Juventus-Technikerschule-HF/EduboardV2_ESP32-S3/EduboardV2_ESP32-S3/EduboardV2_ESP32-S3.kicad_pcb

## KiCad design EduboardV2_ESP32-S3/EduboardV2_ESP32-S3.kicad_pcb (2024-07-12)

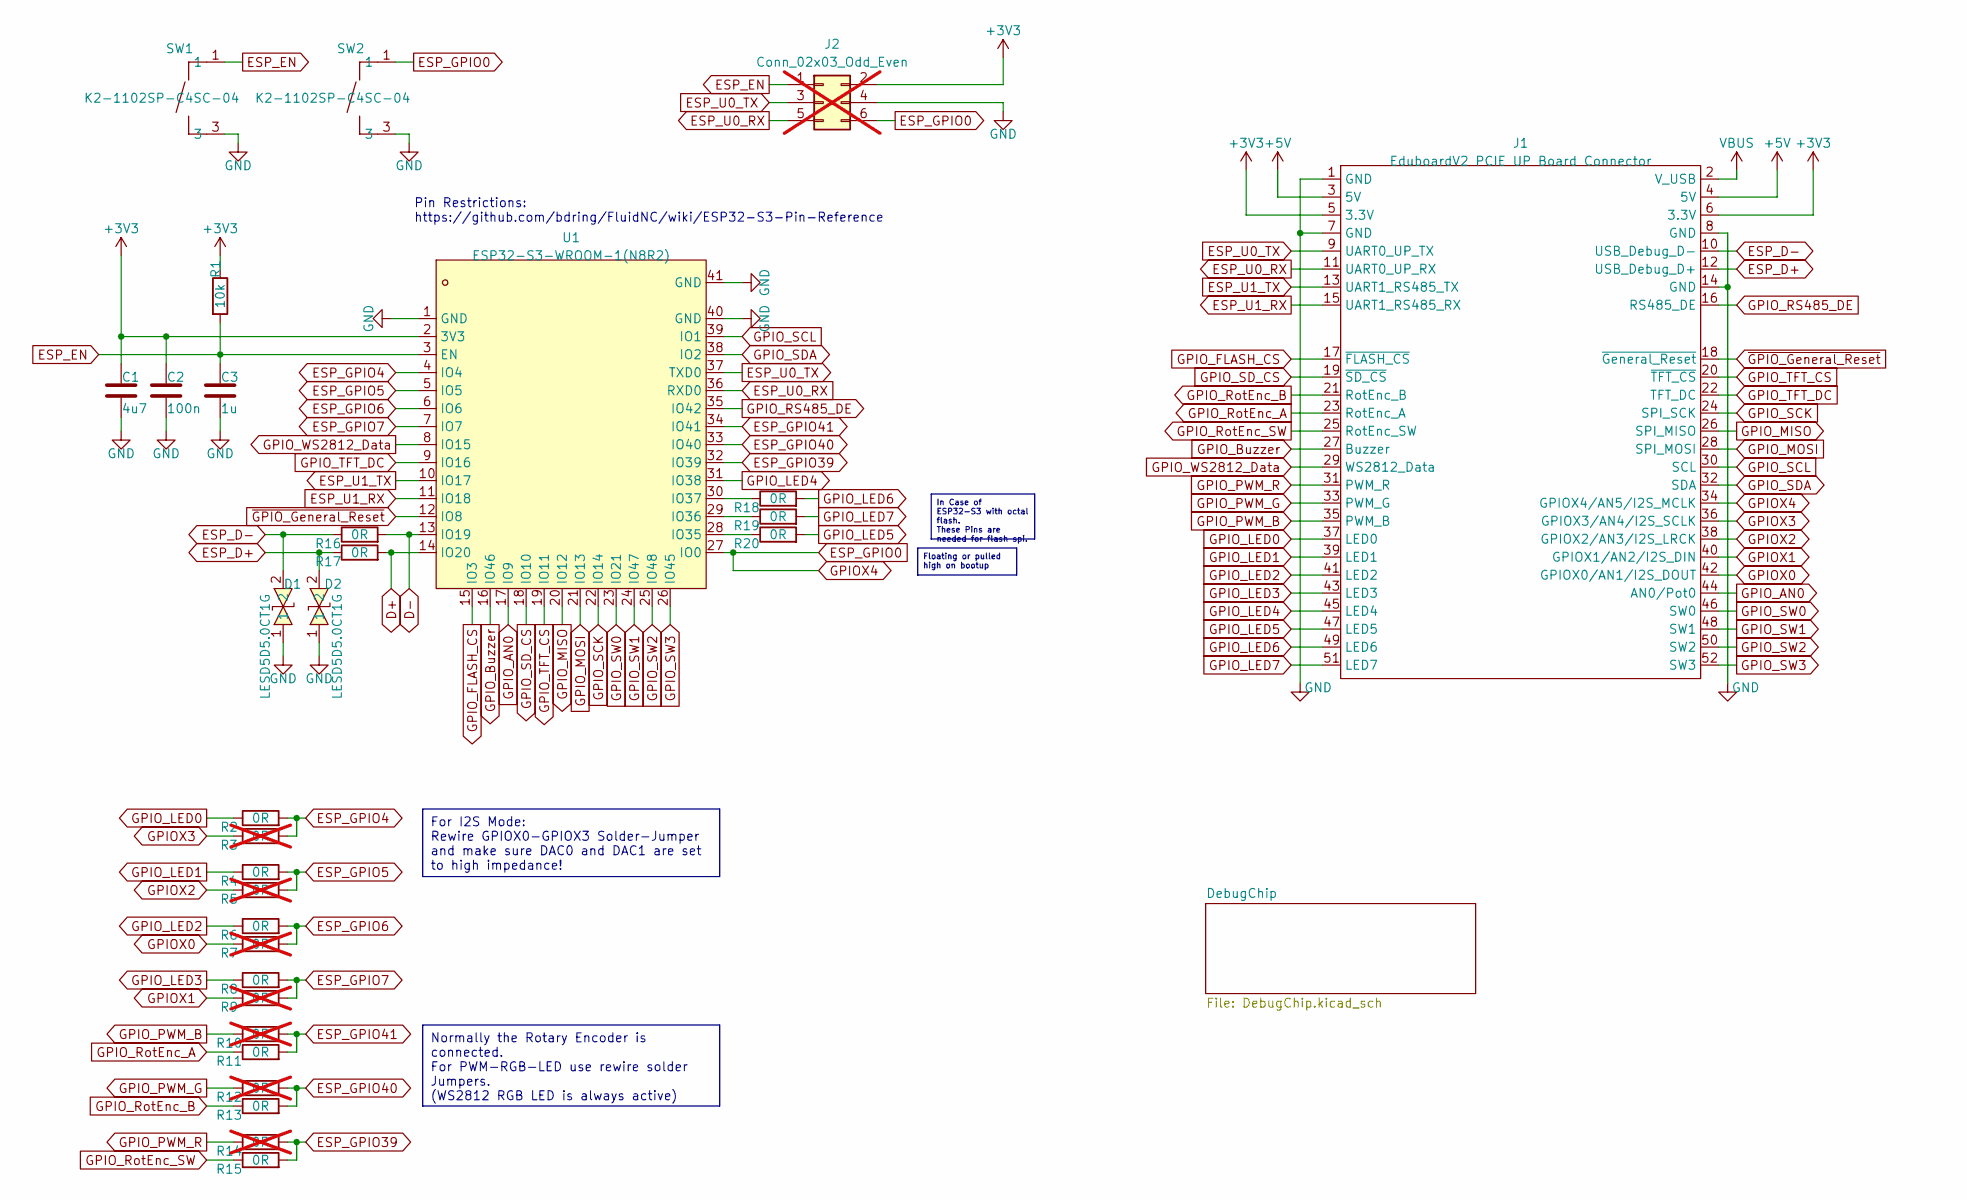
[picture p1: schematic EduboardV2_ESP32-S3.kicad_sch]

Parts:
C1: 4u7; C_0805_2012Metric; JLCPCB Part # C76642
C2: 100n; C_0603_1608Metric; JLCPCB Part # C105907
C3: 1u; C_0805_2012Metric; JLCPCB Part # C77083
D1, D2: LESD5D5.0CT1G; SOD-523_L1.2-W0.8-LS1.6-BI; LCSC Part C383211
J1: EduboardV2 PCIE UP Board Connector; mini-PCIe_F1_Full
J2: Conn_02x03_Odd_Even; PinHeader_2x03_P2.54mm_Vertical; not fitted
R1: 10k; R_0402_1005Metric; JLCPCB Part # C71617
R2, R4, R6, R8, R11, R13, R15, R16, R17, R18, R19, R20: 0R; R_0603_1608Metric; LCSC Part C465460
R3, R5, R7, R9, R10, R12, R14: 0R; R_0603_1608Metric; LCSC Part C465460; not fitted
SW1, SW2: K2-1102SP-C4SC-04; KEY-SMD_4P-L6.0-W6.0-P4.50-LS9.5-BL; LCSC Part C127509
U1: ESP32-S3-WROOM-1(N8R2); WIRELM-SMD_ESP32-S3-WROOM-1; LCSC Part C2913204

Connections:
+3V3: C1.2, C2.1, J1.5 (3.3V), J1.6 (3.3V), J2.2, R1.1, U1.2 (3V3)
+5V: J1.3 (5V), J1.4 (5V)
D+: R17.2, U1.14 (IO20)
D-: R16.2, U1.13 (IO19)
ESP_D+: D2.2, J1.12 (USB_Debug_D+), R17.1
ESP_D-: D1.2, J1.10 (USB_Debug_D-), R16.1
ESP_EN: C3.2, J2.1, R1.2, SW1.1, SW1.2, U1.3 (EN)
ESP_GPIO0: J1.34 (GPIOX4/AN5/I2S_MCLK), J2.6, SW2.1, SW2.2, U1.27 (IO0)
ESP_GPIO4: R2.2, R3.2, U1.4 (IO4)
ESP_GPIO5: R4.2, R5.2, U1.5 (IO5)
ESP_GPIO6: R6.2, R7.2, U1.6 (IO6)
ESP_GPIO7: R8.2, R9.2, U1.7 (IO7)
ESP_GPIO39: R14.2, R15.2, U1.32 (IO39)
ESP_GPIO40: R12.2, R13.2, U1.33 (IO40)
ESP_GPIO41: R10.2, R11.2, U1.34 (IO41)
ESP_U0_RX: J1.11 (UART0_UP_RX), J2.5, U1.36 (RXD0)
ESP_U0_TX: J1.9 (UART0_UP_TX), J2.3, U1.37 (TXD0)
ESP_U1_RX: J1.15 (UART1_RS485_RX), U1.11 (IO18)
ESP_U1_TX: J1.13 (UART1_RS485_TX), U1.10 (IO17)
GND: C1.1, C2.2, C3.1, D1.1, D2.1, J1.1 (GND), J1.7 (GND), J1.8 (GND), J1.14 (GND), J2.4, SW1.3, SW1.4, SW2.3, SW2.4, U1.1 (GND), U1.40 (GND), U1.41 (GND)
GPIOX0: J1.42 (GPIOX0/AN1/I2S_DOUT), R7.1
GPIOX1: J1.40 (GPIOX1/AN2/I2S_DIN), R9.1
GPIOX2: J1.38 (GPIOX2/AN3/I2S_LRCK), R5.1
GPIOX3: J1.36 (GPIOX3/AN4/I2S_SCLK), R3.1
GPIO_AN0: J1.44 (AN0/Pot0), U1.17 (IO9)
GPIO_Buzzer: J1.27 (Buzzer), U1.16 (IO46)
GPIO_FLASH_CS: J1.17 (~FLASH_CS), U1.15 (IO3)
GPIO_LED0: J1.37 (LED0), R2.1
GPIO_LED1: J1.39 (LED1), R4.1
GPIO_LED2: J1.41 (LED2), R6.1
GPIO_LED3: J1.43 (LED3), R8.1
GPIO_LED4: J1.45 (LED4), U1.31 (IO38)
GPIO_LED5: J1.47 (LED5), R20.2
GPIO_LED6: J1.49 (LED6), R18.2
GPIO_LED7: J1.51 (LED7), R19.2
GPIO_MISO: J1.26 (SPI_MISO), U1.20 (IO12)
GPIO_MOSI: J1.28 (SPI_MOSI), U1.21 (IO13)
GPIO_PWM_B: J1.35 (PWM_B), R10.1
GPIO_PWM_G: J1.33 (PWM_G), R12.1
GPIO_PWM_R: J1.31 (PWM_R), R14.1
GPIO_RS485_DE: J1.16 (RS485_DE), U1.35 (IO42)
GPIO_RotEnc_A: J1.23 (RotEnc_A), R11.1
GPIO_RotEnc_B: J1.21 (RotEnc_B), R13.1
GPIO_RotEnc_SW: J1.25 (RotEnc_SW), R15.1
GPIO_SCK: J1.24 (SPI_SCK), U1.22 (IO14)
GPIO_SCL: J1.30 (SCL), U1.39 (IO1)
GPIO_SDA: J1.32 (SDA), U1.38 (IO2)
GPIO_SD_CS: J1.19 (~SD_CS), U1.18 (IO10)
GPIO_SW0: J1.46 (SW0), U1.23 (IO21)
GPIO_SW1: J1.48 (SW1), U1.24 (IO47)
GPIO_SW2: J1.50 (SW2), U1.25 (IO48)
GPIO_SW3: J1.52 (SW3), U1.26 (IO45)
GPIO_TFT_CS: J1.20 (~TFT_CS), U1.19 (IO11)
GPIO_TFT_DC: J1.22 (TFT_DC), U1.9 (IO16)
GPIO_WS2812_Data: J1.29 (WS2812_Data), U1.8 (IO15)
unnamed: R20.1, U1.28 (IO35)
unnamed: R19.1, U1.29 (IO36)
unnamed: R18.1, U1.30 (IO37)
VBUS: J1.2 (V_USB)
~GPIO_General_Reset: J1.18 (~General_Reset), U1.12 (IO8)

Notes on the sheet:
For I2S Mode: Rewire GPIOX0-GPIOX3 Solder-Jumper and make sure DAC0 and DAC1 are set to high impedance!
Normally the Rotary Encoder is connected. For PWM-RGB-LED use rewire solder Jumpers. (WS2812 RGB LED is always active)
Floating or pulled high on bootup
In Case of ESP32-S3 with octal flash. These Pins are needed for flash spi.
Pin Restrictions: https://github.com/bdring/FluidNC/wiki/ESP32-S3-Pin-Reference

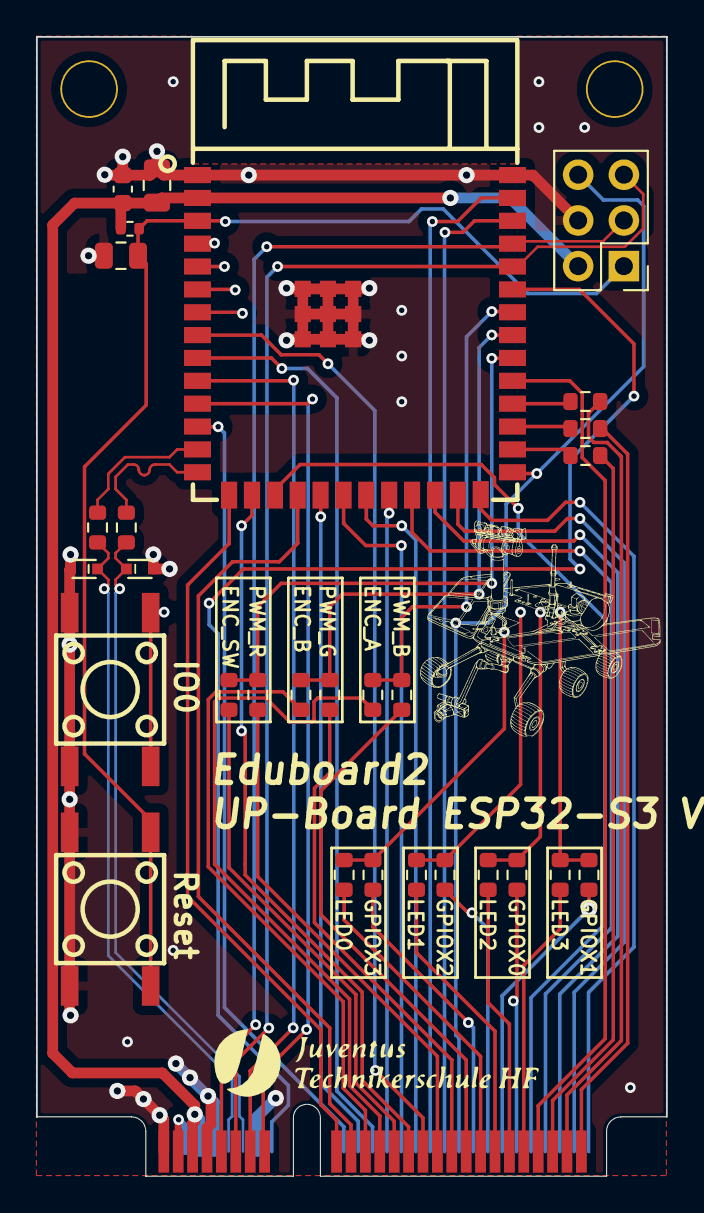
[picture p2: board EduboardV2_ESP32-S3.kicad_pcb from above]

Board: 4 copper layers, 35.0 x 63.3 mm, 30 parts (0 on the bottom side), 59 nets.
