Juventus-Technikerschule-HF/EduboardV2_ESP32-S3/(threads)

Thread 1 (2023-05-29):

Get rid of USB Connection. Not nescessary.

mburger82, 2023-05-29:
USB Port of ESP32-S3 directly connected to USB-Port of Baseboard should be plenty for Debugging and Serial Connection. According to tests with S3 Devboard working perfectly!
There should be a 6Pin ESP-Prog Programming Port on the Board for External Programming. But otherwise nothing else!

mburger82, 2023-05-29:
Also the USB Serial Converter can go and the Serial directly connected to the Baseboard Serial.
Maybe keep some IO0 and Reset Buttons on the Board to be able to program it manually if nescessary.

mburger82, 2023-06-25:
done 41fb6079ff77361fca5ebb2e7249d56c8b82720b

Closed 2023-06-25.

Thread 2 (2023-06-25):

Get rid of 3.3V Voltage regulator

mburger82, 2023-06-25:

mburger82, 2023-06-25:
not nescessary when USB Connector on Board is not present

mburger82, 2023-06-25:
done 41fb6079ff77361fca5ebb2e7249d56c8b82720b

Closed 2023-06-25.

Thread 3 (2023-07-01):

Remove Soldermask from m.2 pins to prevent ENIG getting battered with solder!

mburger82, 2023-07-01:
