Juventus-Technikerschule-HF/EduboardV2_ESP32-S3/(commit log)

2023-04-27 initial commit of ESP32-S3 UP Board. USB-Serial done. Start distributing pins
    [DebugChip.kicad_sch, EduboardV2_ESP32-S3.kicad_pcb, EduboardV2_ESP32-S3.kicad_sch]
2023-04-28 distribute signals to pins
    [DebugChip.kicad_sch, EduboardV2_ESP32-S3.kicad_sch]
2023-05-01 finish schematic. Do Layout
    [DebugChip.kicad_sch, EduboardV2_ESP32-S3.kicad_pcb, EduboardV2_ESP32-S3.kicad_sch]
2023-05-02 add logo
    [EduboardV2_ESP32-S3.kicad_pcb]
2023-05-06 add jumper description on board
    [DebugChip.kicad_sch, EduboardV2_ESP32-S3.kicad_pcb, EduboardV2_ESP32-S3.kicad_sch]
2023-06-25 Do all modifications for V1.1 and create production data
    [DebugChip.kicad_sch, EduboardV2_ESP32-S3.kicad_pcb, EduboardV2_ESP32-S3.kicad_sch]
2024-07-12 migrate to kicad v8.
    [DebugChip.kicad_sch, EduboardV2_ESP32-S3.kicad_pcb, EduboardV2_ESP32-S3.kicad_sch]
